byungyoonc/TrueStrike56/hw/pcb/TrueStrike56.kicad_pcb

## KiCad design hw/pcb/TrueStrike56.kicad_pcb (2026-02-21)

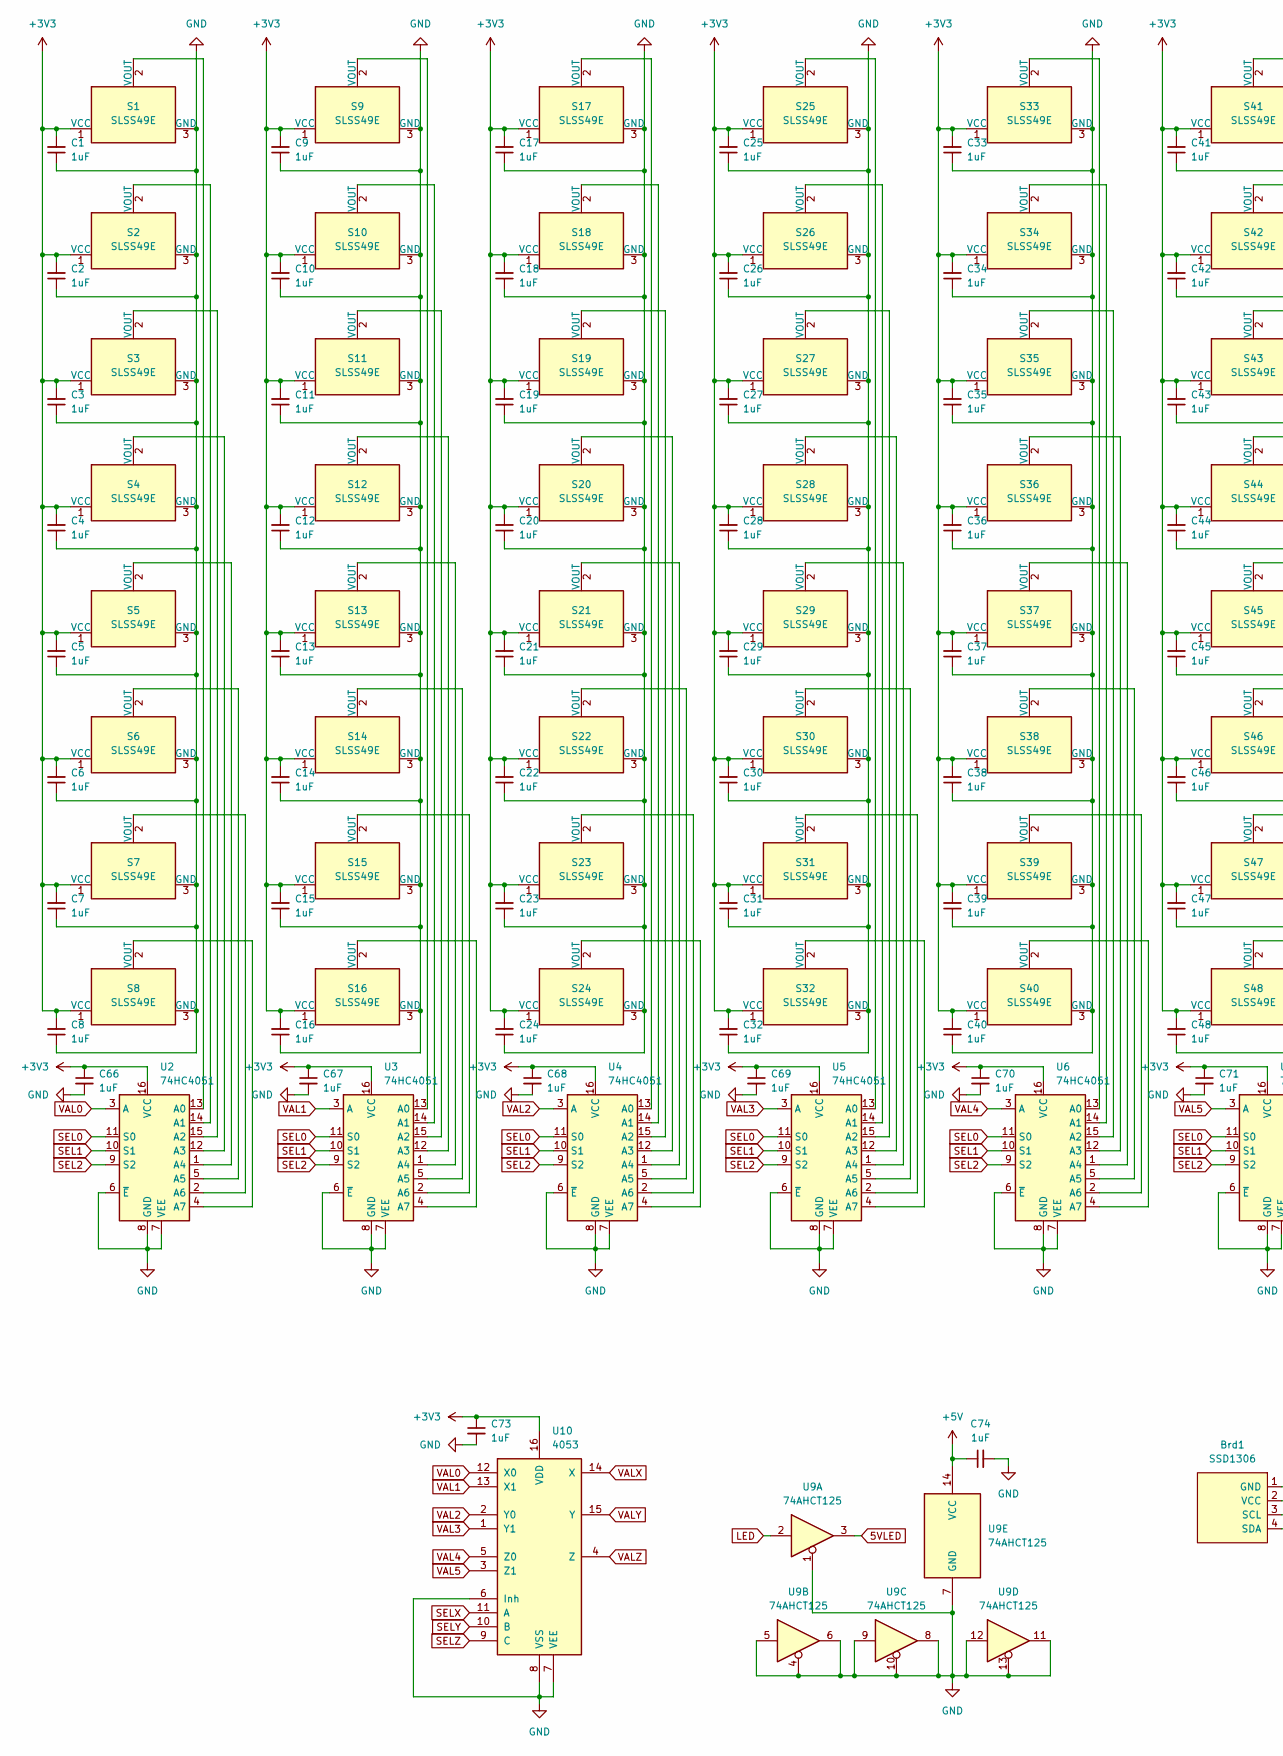
[picture p1: schematic TrueStrike56.kicad_sch, part in row 1, column 1]

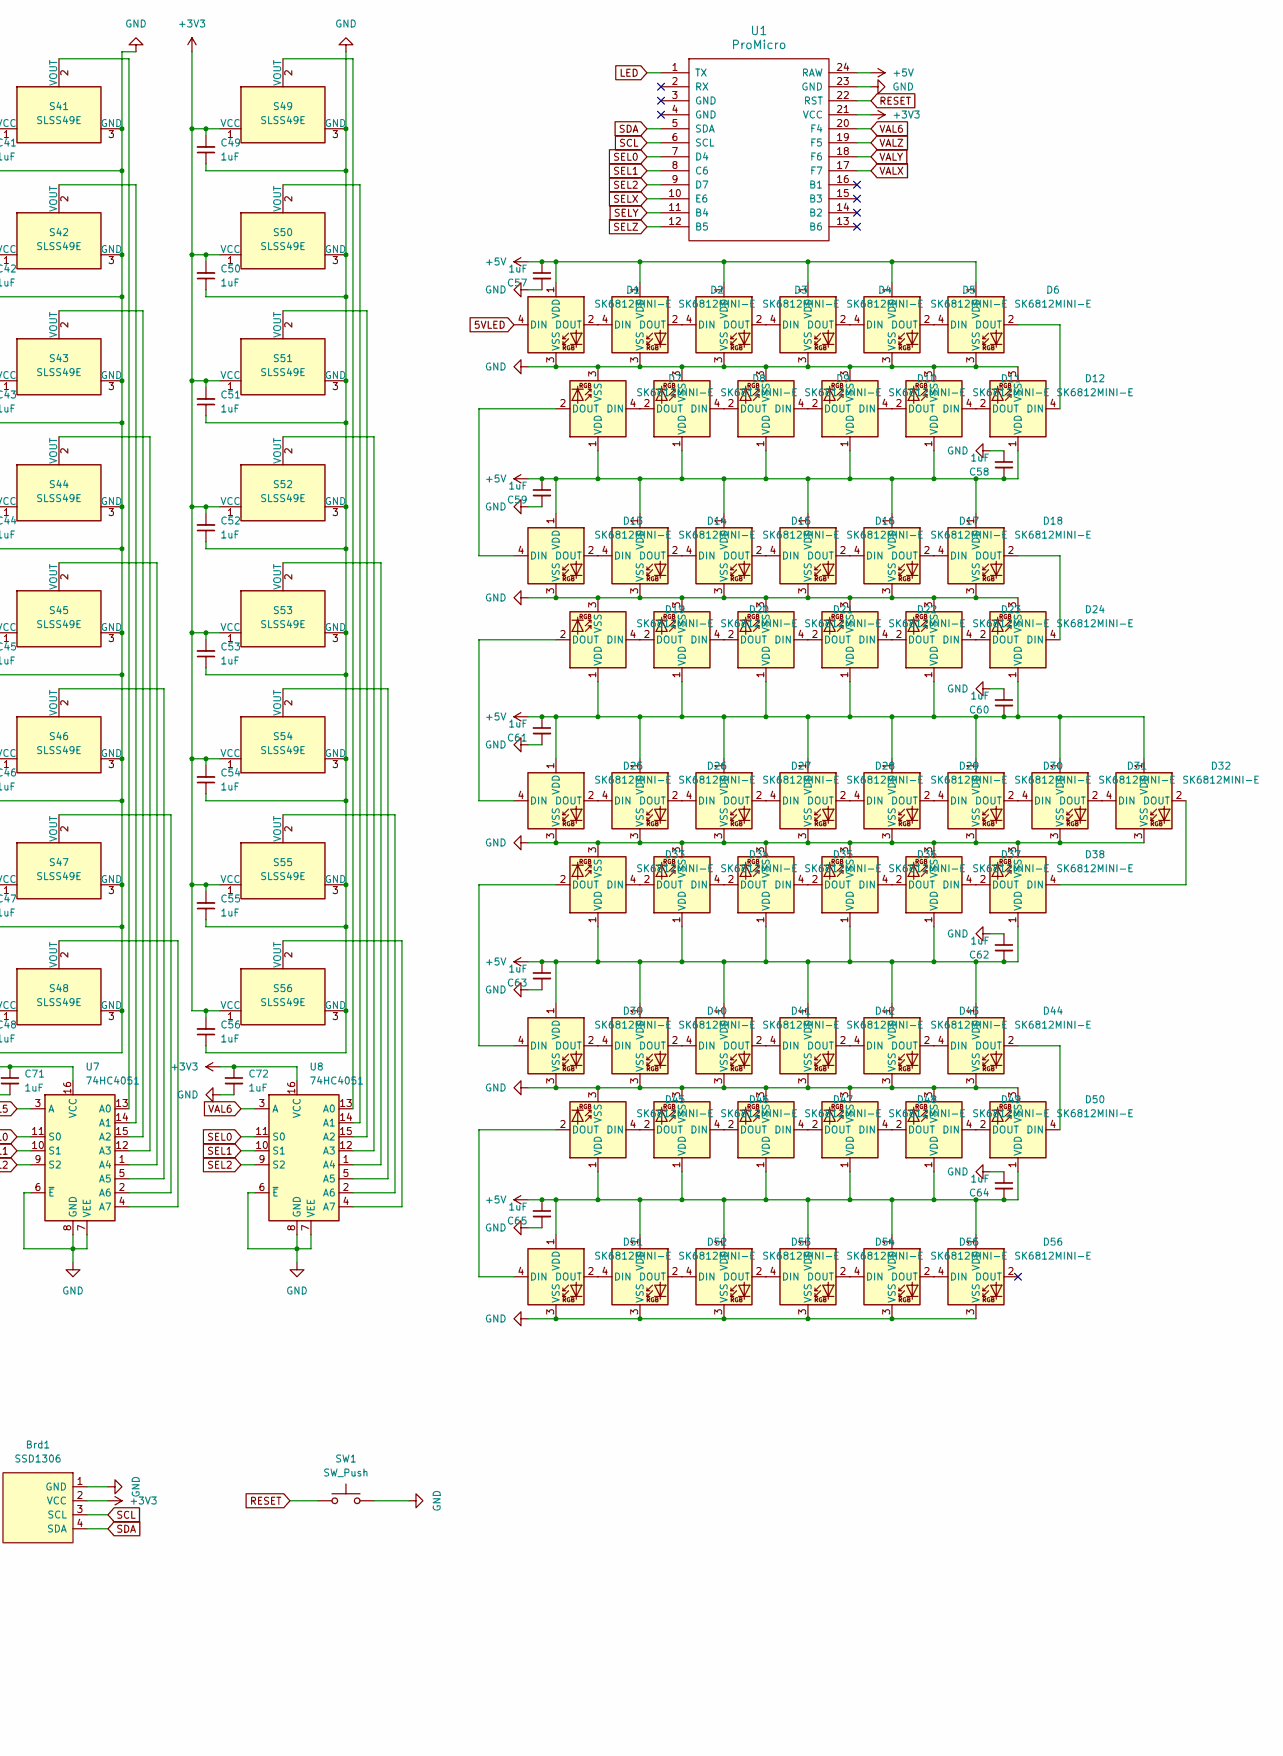
[picture p2: schematic TrueStrike56.kicad_sch, part in row 1, column 2]

Parts:
Brd1: SSD1306; 128x64OLED
C1, C2, C3, C4, C5, C6, C7, C8, C9, C10, C11, C12, C13, C14, C15, C16, C17, C18, C19, C20, C21, C22, C23, C24, C25, C26, C27, C28, C29, C30, C31, C32, C33, C34, C35, C36, C37, C38, C39, C40, C41, C42, C43, C44, C45, C46, C47, C48, C49, C50, C51, C52, C53, C54, C55, C56, C57, C58, C59, C60, C61, C62, C63, C64, C65, C66, C67, C68, C69, C70, C71, C72, C73, C74: 1uF; C_0805_2012Metric_Pad1.18x1.45mm_HandSolder; LCSC Part # C28233
D1, D2, D3, D4, D5, D6, D13, D14, D15, D16, D17, D18, D33, D34, D35, D36, D37, D38, D45, D46, D47, D48, D49, D50: SK6812MINI-E; SK6812MINI-E_nusumi; LCSC Part # C5149201
D7, D8, D9, D10, D11, D12, D19, D20, D21, D22, D23, D24, D25, D26, D27, D28, D29, D30, D31, D32, D39, D40, D41, D42, D43, D44, D51, D52, D53, D54, D55, D56: SK6812MINI-E; SK6812MINI-E_nusumi_Rotated; LCSC Part # C5149201
S1, S2, S3, S4, S5, S6, S7, S8, S9, S10, S11, S12, S13, S14, S15, S16, S17, S18, S19, S20, S21, S22, S23, S24, S25, S26, S27, S28, S29, S30, S31, S32, S33, S34, S35, S36, S37, S38, S39, S40, S41, S42, S43, S44, S45, S46, S47, S48, S49, S50, S51, S54, S55, S56: SLSS49E; HE-Switch-1U; LCSC Part # C126669
S52, S53: SLSS49E; HE-Switch-1.5U; LCSC Part # C126669
SW1: SW_Push; SW_Push_1P1T_XKB_TS-1187A; LCSC Part # C318884
U1: ProMicro
U2, U3, U4, U5, U6, U7, U8: 74HC4051; SOIC-16_3.9x9.9mm_P1.27mm; LCSC Part # C85220
U9: 74AHCT125; SOIC-14_3.9x8.7mm_P1.27mm; LCSC Part # C155176
U10: 4053; SOIC-16_3.9x9.9mm_P1.27mm; LCSC Part # C5647

Connections:
5VLED: D1.4 (DIN), U9.3
+3V3: Brd1.2 (VCC), C1.2, C2.2, C3.2, C4.2, C5.2, C6.2, C7.2, C8.2, C9.2, C10.2, C11.2, C12.2, C13.2, C14.2, C15.2, C16.2, C17.2, C18.2, C19.2, C20.2, C21.2, C22.2, C23.2, C24.2, C25.2, C26.2, C27.2, C28.2, C29.2, C30.2, C31.2, C32.2, C33.2, C34.2, C35.2, C36.2, C37.2, C38.2, C39.2, C40.2, C41.2, C42.2, C43.2, C44.2, C45.2, C46.2, C47.2, C48.2, C49.2, C50.2, C51.2, C52.2, C53.2, C54.2, C55.2, C56.2, C66.1, C67.1, C68.1, C69.1, C70.1, C71.1, C72.1, C73.1, S1.1 (VCC), S2.1 (VCC), S3.1 (VCC), S4.1 (VCC), S5.1 (VCC), S6.1 (VCC), S7.1 (VCC), S8.1 (VCC), S9.1 (VCC), S10.1 (VCC), S11.1 (VCC), S12.1 (VCC), S13.1 (VCC), S14.1 (VCC), S15.1 (VCC), S16.1 (VCC), S17.1 (VCC), S18.1 (VCC), S19.1 (VCC), S20.1 (VCC), S21.1 (VCC), S22.1 (VCC), S23.1 (VCC), S24.1 (VCC), S25.1 (VCC), S26.1 (VCC), S27.1 (VCC), S28.1 (VCC), S29.1 (VCC), S30.1 (VCC), S31.1 (VCC), S32.1 (VCC), S33.1 (VCC), S34.1 (VCC), S35.1 (VCC), S36.1 (VCC), S37.1 (VCC), S38.1 (VCC), S39.1 (VCC), S40.1 (VCC), S41.1 (VCC), S42.1 (VCC), S43.1 (VCC), S44.1 (VCC), S45.1 (VCC), S46.1 (VCC), S47.1 (VCC), S48.1 (VCC), S49.1 (VCC), S50.1 (VCC), S51.1 (VCC), S52.1 (VCC), S53.1 (VCC), S54.1 (VCC), S55.1 (VCC), S56.1 (VCC), U1.21 (VCC), U2.16 (VCC), U3.16 (VCC), U4.16 (VCC), U5.16 (VCC), U6.16 (VCC), U7.16 (VCC), U8.16 (VCC), U10.16 (VDD)
+5V: C57.1, C58.2, C59.1, C60.2, C61.1, C62.2, C63.1, C64.2, C65.1, C74.1, D1.1 (VDD), D2.1 (VDD), D3.1 (VDD), D4.1 (VDD), D5.1 (VDD), D6.1 (VDD), D7.1 (VDD), D8.1 (VDD), D9.1 (VDD), D10.1 (VDD), D11.1 (VDD), D12.1 (VDD), D13.1 (VDD), D14.1 (VDD), D15.1 (VDD), D16.1 (VDD), D17.1 (VDD), D18.1 (VDD), D19.1 (VDD), D20.1 (VDD), D21.1 (VDD), D22.1 (VDD), D23.1 (VDD), D24.1 (VDD), D25.1 (VDD), D26.1 (VDD), D27.1 (VDD), D28.1 (VDD), D29.1 (VDD), D30.1 (VDD), D31.1 (VDD), D32.1 (VDD), D33.1 (VDD), D34.1 (VDD), D35.1 (VDD), D36.1 (VDD), D37.1 (VDD), D38.1 (VDD), D39.1 (VDD), D40.1 (VDD), D41.1 (VDD), D42.1 (VDD), D43.1 (VDD), D44.1 (VDD), D45.1 (VDD), D46.1 (VDD), D47.1 (VDD), D48.1 (VDD), D49.1 (VDD), D50.1 (VDD), D51.1 (VDD), D52.1 (VDD), D53.1 (VDD), D54.1 (VDD), D55.1 (VDD), D56.1 (VDD), U1.24 (RAW), U9.14 (VCC)
GND: Brd1.1 (GND), C1.1, C2.1, C3.1, C4.1, C5.1, C6.1, C7.1, C8.1, C9.1, C10.1, C11.1, C12.1, C13.1, C14.1, C15.1, C16.1, C17.1, C18.1, C19.1, C20.1, C21.1, C22.1, C23.1, C24.1, C25.1, C26.1, C27.1, C28.1, C29.1, C30.1, C31.1, C32.1, C33.1, C34.1, C35.1, C36.1, C37.1, C38.1, C39.1, C40.1, C41.1, C42.1, C43.1, C44.1, C45.1, C46.1, C47.1, C48.1, C49.1, C50.1, C51.1, C52.1, C53.1, C54.1, C55.1, C56.1, C57.2, C58.1, C59.2, C60.1, C61.2, C62.1, C63.2, C64.1, C65.2, C66.2, C67.2, C68.2, C69.2, C70.2, C71.2, C72.2, C73.2, C74.2, D1.3 (VSS), D2.3 (VSS), D3.3 (VSS), D4.3 (VSS), D5.3 (VSS), D6.3 (VSS), D7.3 (VSS), D8.3 (VSS), D9.3 (VSS), D10.3 (VSS), D11.3 (VSS), D12.3 (VSS), D13.3 (VSS), D14.3 (VSS), D15.3 (VSS), D16.3 (VSS), D17.3 (VSS), D18.3 (VSS), D19.3 (VSS), D20.3 (VSS), D21.3 (VSS), D22.3 (VSS), D23.3 (VSS), D24.3 (VSS), D25.3 (VSS), D26.3 (VSS), D27.3 (VSS), D28.3 (VSS), D29.3 (VSS), D30.3 (VSS), D31.3 (VSS), D32.3 (VSS), D33.3 (VSS), D34.3 (VSS), D35.3 (VSS), D36.3 (VSS), D37.3 (VSS), D38.3 (VSS), D39.3 (VSS), D40.3 (VSS), D41.3 (VSS), D42.3 (VSS), D43.3 (VSS), D44.3 (VSS), D45.3 (VSS), D46.3 (VSS), D47.3 (VSS), D48.3 (VSS), D49.3 (VSS), D50.3 (VSS), D51.3 (VSS), D52.3 (VSS), D53.3 (VSS), D54.3 (VSS), D55.3 (VSS), D56.3 (VSS), S1.3 (GND), S2.3 (GND), S3.3 (GND), S4.3 (GND), S5.3 (GND), S6.3 (GND), S7.3 (GND), S8.3 (GND), S9.3 (GND), S10.3 (GND), S11.3 (GND), S12.3 (GND), S13.3 (GND), S14.3 (GND), S15.3 (GND), S16.3 (GND), S17.3 (GND), S18.3 (GND), S19.3 (GND), S20.3 (GND), S21.3 (GND), S22.3 (GND), S23.3 (GND), S24.3 (GND), S25.3 (GND), S26.3 (GND), S27.3 (GND), S28.3 (GND), S29.3 (GND), S30.3 (GND), S31.3 (GND), S32.3 (GND), S33.3 (GND), S34.3 (GND), S35.3 (GND), S36.3 (GND), S37.3 (GND), S38.3 (GND), S39.3 (GND), S40.3 (GND), S41.3 (GND), S42.3 (GND), S43.3 (GND), S44.3 (GND), S45.3 (GND), S46.3 (GND), S47.3 (GND), S48.3 (GND), S49.3 (GND), S50.3 (GND), S51.3 (GND), S52.3 (GND), S53.3 (GND), S54.3 (GND), S55.3 (GND), S56.3 (GND), SW1.2, U1.23 (GND), U2.6 (~E), U2.7 (VEE), U2.8 (GND), U3.6 (~E), U3.7 (VEE), U3.8 (GND), U4.6 (~E), U4.7 (VEE), U4.8 (GND), U5.6 (~E), U5.7 (VEE), U5.8 (GND), U6.6 (~E), U6.7 (VEE), U6.8 (GND), U7.6 (~E), U7.7 (VEE), U7.8 (GND), U8.6 (~E), U8.7 (VEE), U8.8 (GND), U9.1, U9.4, U9.5, U9.6, U9.7 (GND), U9.8, U9.9, U9.10, U9.11, U9.12, U9.13, U10.6 (Inh), U10.7 (VEE), U10.8 (VSS)
LED: U1.1 (TX), U9.2
unnamed: D1.2 (DOUT), D2.4 (DIN)
unnamed: D2.2 (DOUT), D3.4 (DIN)
unnamed: D3.2 (DOUT), D4.4 (DIN)
unnamed: D4.2 (DOUT), D5.4 (DIN)
unnamed: D5.2 (DOUT), D6.4 (DIN)
unnamed: D7.4 (DIN), D8.2 (DOUT)
unnamed: D8.4 (DIN), D9.2 (DOUT)
unnamed: D10.4 (DIN), D11.2 (DOUT)
unnamed: D9.4 (DIN), D10.2 (DOUT)
unnamed: D11.4 (DIN), D12.2 (DOUT)
unnamed: D6.2 (DOUT), D12.4 (DIN)
unnamed: D7.2 (DOUT), D13.4 (DIN)
unnamed: D13.2 (DOUT), D14.4 (DIN)
unnamed: D14.2 (DOUT), D15.4 (DIN)
unnamed: D15.2 (DOUT), D16.4 (DIN)
unnamed: D16.2 (DOUT), D17.4 (DIN)
unnamed: D17.2 (DOUT), D18.4 (DIN)
unnamed: D18.2 (DOUT), D24.4 (DIN)
unnamed: D19.4 (DIN), D20.2 (DOUT)
unnamed: D19.2 (DOUT), D25.4 (DIN)
unnamed: D20.4 (DIN), D21.2 (DOUT)
unnamed: D21.4 (DIN), D22.2 (DOUT)
unnamed: D22.4 (DIN), D23.2 (DOUT)
unnamed: D23.4 (DIN), D24.2 (DOUT)
unnamed: D25.2 (DOUT), D26.4 (DIN)
unnamed: D26.2 (DOUT), D27.4 (DIN)
unnamed: D27.2 (DOUT), D28.4 (DIN)
unnamed: D28.2 (DOUT), D29.4 (DIN)
unnamed: D29.2 (DOUT), D30.4 (DIN)
unnamed: D30.2 (DOUT), D31.4 (DIN)
unnamed: D31.2 (DOUT), D32.4 (DIN)
unnamed: D32.2 (DOUT), D38.4 (DIN)
unnamed: D33.4 (DIN), D34.2 (DOUT)
unnamed: D33.2 (DOUT), D39.4 (DIN)
unnamed: D34.4 (DIN), D35.2 (DOUT)
unnamed: D35.4 (DIN), D36.2 (DOUT)
unnamed: D36.4 (DIN), D37.2 (DOUT)
unnamed: D37.4 (DIN), D38.2 (DOUT)
unnamed: D39.2 (DOUT), D40.4 (DIN)
unnamed: D40.2 (DOUT), D41.4 (DIN)
unnamed: D41.2 (DOUT), D42.4 (DIN)
unnamed: D42.2 (DOUT), D43.4 (DIN)
unnamed: D43.2 (DOUT), D44.4 (DIN)
unnamed: D44.2 (DOUT), D50.4 (DIN)
unnamed: D45.4 (DIN), D46.2 (DOUT)
unnamed: D45.2 (DOUT), D51.4 (DIN)
unnamed: D46.4 (DIN), D47.2 (DOUT)
unnamed: D47.4 (DIN), D48.2 (DOUT)
unnamed: D48.4 (DIN), D49.2 (DOUT)
unnamed: D49.4 (DIN), D50.2 (DOUT)
unnamed: D51.2 (DOUT), D52.4 (DIN)
unnamed: D52.2 (DOUT), D53.4 (DIN)
unnamed: D53.2 (DOUT), D54.4 (DIN)
unnamed: D54.2 (DOUT), D55.4 (DIN)
unnamed: D55.2 (DOUT), D56.4 (DIN)
unnamed: S1.2 (VOUT), U2.13 (A0)
unnamed: S2.2 (VOUT), U2.14 (A1)
unnamed: S3.2 (VOUT), U2.15 (A2)
unnamed: S4.2 (VOUT), U2.12 (A3)
unnamed: S5.2 (VOUT), U2.1 (A4)
unnamed: S6.2 (VOUT), U2.5 (A5)
unnamed: S7.2 (VOUT), U2.2 (A6)
unnamed: S8.2 (VOUT), U2.4 (A7)
unnamed: S9.2 (VOUT), U3.13 (A0)
unnamed: S10.2 (VOUT), U3.14 (A1)
unnamed: S11.2 (VOUT), U3.15 (A2)
unnamed: S12.2 (VOUT), U3.12 (A3)
unnamed: S13.2 (VOUT), U3.1 (A4)
unnamed: S14.2 (VOUT), U3.5 (A5)
unnamed: S15.2 (VOUT), U3.2 (A6)
unnamed: S16.2 (VOUT), U3.4 (A7)
unnamed: S17.2 (VOUT), U4.13 (A0)
unnamed: S18.2 (VOUT), U4.14 (A1)
unnamed: S19.2 (VOUT), U4.15 (A2)
unnamed: S20.2 (VOUT), U4.12 (A3)
unnamed: S21.2 (VOUT), U4.1 (A4)
unnamed: S22.2 (VOUT), U4.5 (A5)
unnamed: S23.2 (VOUT), U4.2 (A6)
unnamed: S24.2 (VOUT), U4.4 (A7)
unnamed: S25.2 (VOUT), U5.13 (A0)
unnamed: S26.2 (VOUT), U5.14 (A1)
unnamed: S27.2 (VOUT), U5.15 (A2)
unnamed: S28.2 (VOUT), U5.12 (A3)
unnamed: S29.2 (VOUT), U5.1 (A4)
unnamed: S30.2 (VOUT), U5.5 (A5)
unnamed: S31.2 (VOUT), U5.2 (A6)
unnamed: S32.2 (VOUT), U5.4 (A7)
unnamed: S33.2 (VOUT), U6.13 (A0)
unnamed: S34.2 (VOUT), U6.14 (A1)
unnamed: S35.2 (VOUT), U6.15 (A2)
unnamed: S36.2 (VOUT), U6.12 (A3)
unnamed: S37.2 (VOUT), U6.1 (A4)
unnamed: S38.2 (VOUT), U6.5 (A5)
unnamed: S39.2 (VOUT), U6.2 (A6)
unnamed: S40.2 (VOUT), U6.4 (A7)
unnamed: S41.2 (VOUT), U7.13 (A0)
unnamed: S42.2 (VOUT), U7.14 (A1)
unnamed: S43.2 (VOUT), U7.15 (A2)
unnamed: S44.2 (VOUT), U7.12 (A3)
unnamed: S45.2 (VOUT), U7.1 (A4)
unnamed: S46.2 (VOUT), U7.5 (A5)
unnamed: S47.2 (VOUT), U7.2 (A6)
unnamed: S48.2 (VOUT), U7.4 (A7)
unnamed: S49.2 (VOUT), U8.13 (A0)
unnamed: S50.2 (VOUT), U8.14 (A1)
unnamed: S51.2 (VOUT), U8.15 (A2)
unnamed: S52.2 (VOUT), U8.12 (A3)
unnamed: S53.2 (VOUT), U8.1 (A4)
unnamed: S54.2 (VOUT), U8.5 (A5)
unnamed: S55.2 (VOUT), U8.2 (A6)
unnamed: S56.2 (VOUT), U8.4 (A7)
RESET: SW1.1, U1.22 (RST)
SCL: Brd1.3 (SCL), U1.6 (SCL)
SDA: Brd1.4 (SDA), U1.5 (SDA)
SEL0: U1.7 (D4), U2.11 (S0), U3.11 (S0), U4.11 (S0), U5.11 (S0), U6.11 (S0), U7.11 (S0), U8.11 (S0)
SEL1: U1.8 (C6), U2.10 (S1), U3.10 (S1), U4.10 (S1), U5.10 (S1), U6.10 (S1), U7.10 (S1), U8.10 (S1)
SEL2: U1.9 (D7), U2.9 (S2), U3.9 (S2), U4.9 (S2), U5.9 (S2), U6.9 (S2), U7.9 (S2), U8.9 (S2)
SELX: U1.10 (E6), U10.11 (A)
SELY: U1.11 (B4), U10.10 (B)
SELZ: U1.12 (B5), U10.9 (C)
VAL0: U2.3 (A), U10.12 (X0)
VAL1: U3.3 (A), U10.13 (X1)
VAL2: U4.3 (A), U10.2 (Y0)
VAL3: U5.3 (A), U10.1 (Y1)
VAL4: U6.3 (A), U10.5 (Z0)
VAL5: U7.3 (A), U10.3 (Z1)
VAL6: U1.20 (F4), U8.3 (A)
VALX: U1.17 (F7), U10.14 (X)
VALY: U1.18 (F6), U10.15 (Y)
VALZ: U1.19 (F5), U10.4 (Z)

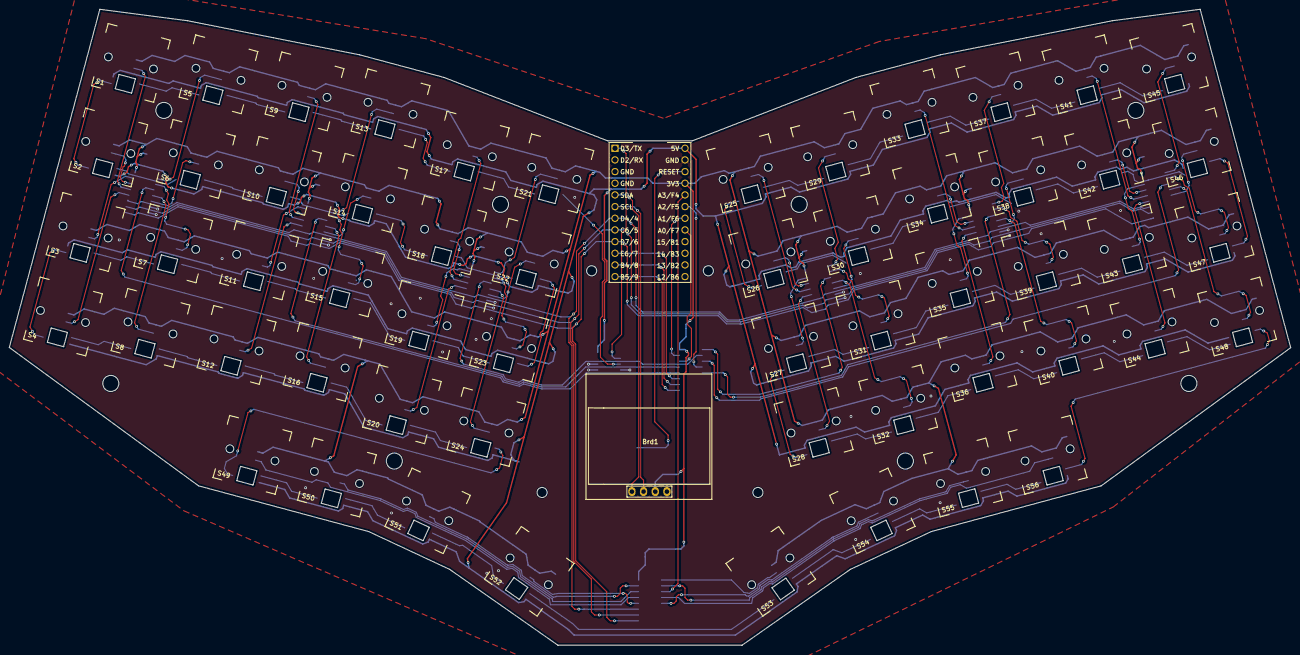
[picture p3: board TrueStrike56.kicad_pcb from above]

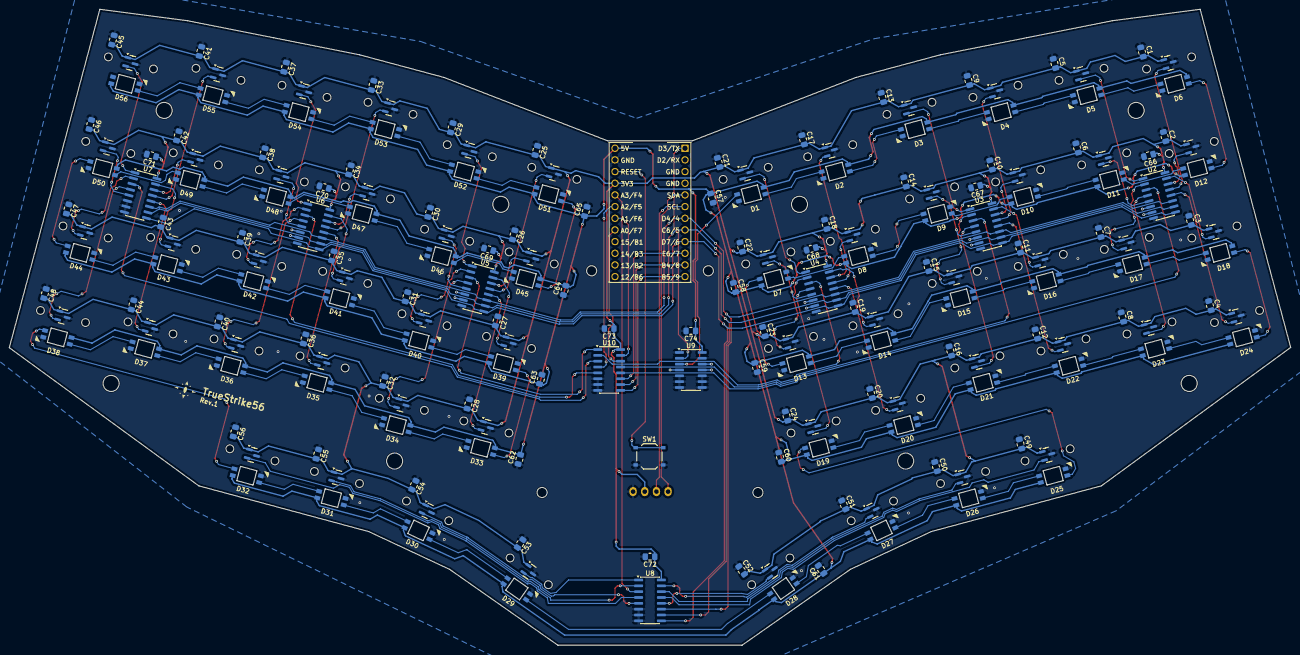
[picture p4: board TrueStrike56.kicad_pcb from below]

Board: 2 copper layers, 278.9 x 138.4 mm, 198 parts (196 on the bottom side), 135 nets.
