byungyoonc/TrueStrike56/fw/rev2/truestrike56/keymaps/via/keymap.c

// Copyright 2025 byungyoonc
// SPDX-License-Identifier: GPL-2.0-or-later

#include QMK_KEYBOARD_H

const uint16_t PROGMEM keymaps[][MATRIX_ROWS][MATRIX_COLS] = {
    [0] = LAYOUT_split_4x6_4(
        KC_ESC,  KC_1,    KC_2,    KC_3,    KC_4,    KC_5,                               KC_6,    KC_7,    KC_8,    KC_9,    KC_0,    KC_DEL,
        KC_TAB,  KC_Q,    KC_W,    KC_E,    KC_R,    KC_T,                               KC_Y,    KC_U,    KC_I,    KC_O,    KC_P,    KC_BSPC,
        KC_LCTL, KC_A,    KC_S,    KC_D,    KC_F,    KC_G,                               KC_H,    KC_J,    KC_K,    KC_L,    KC_SCLN, KC_ENT,
        KC_LSFT, KC_Z,    KC_X,    KC_C,    KC_V,    KC_B,                               KC_N,    KC_M,    KC_COMM, KC_DOT,  KC_SLSH, KC_RSFT,
                                   KC_LGUI, KC_LALT, TL_LOWR, KC_LSFT,          KC_SPC,  TL_UPPR, KC_RALT, KC_RGUI, KC_MUTE
    ),
    [1] = LAYOUT_split_4x6_4(
        _______, _______, _______, _______, _______, _______,                            _______, _______, _______, _______, _______, _______,
        _______, KC_HOME, KC_UP,   KC_END,  KC_PGUP, KC_CAPS,                            KC_NUM,  KC_P7,   KC_P8,   KC_P9,   KC_PMNS, _______,
        _______, KC_LEFT, KC_DOWN, KC_RGHT, KC_PGDN, _______,                            _______, KC_P4,   KC_P5,   KC_P6,   KC_PPLS, _______,
        _______, _______, _______, _______, _______, _______,                            _______, KC_P1,   KC_P2,   KC_P3,   KC_PDOT, _______,
                                   _______, _______, _______, _______,          KC_P0,   _______, _______, _______, _______
    ),
    [2] = LAYOUT_split_4x6_4(
        KC_GRV,  _______, _______, _______, _______, _______,                            _______, _______, _______, _______, _______, _______,
        _______, _______, _______, _______, _______, _______,                            _______, KC_LPRN, KC_RPRN, KC_MINS, KC_EQL,  _______,
        _______, _______, _______, _______, _______, _______,                            _______, KC_LBRC, KC_RBRC, KC_BSLS, KC_QUOT, _______,
        _______, _______, _______, _______, _______, _______,                            _______, _______, _______, _______, _______, _______,
                                   _______, _______, _______, _______,          _______, _______, _______, _______, _______
    ),
    [3] = LAYOUT_split_4x6_4(
        _______, _______, _______, _______, _______, _______,                            _______, _______, _______, _______, _______, _______,
        QK_BOOT, _______, _______, _______, _______, _______,                            _______, KC_F7,   KC_F8,   KC_F9,   KC_F10,  KC_PSCR,
        EE_CLR,  _______, _______, _______, _______, _______,                            _______, KC_F4,   KC_F5,   KC_F6,   KC_F11,  _______,
        _______, NK_TOGG, _______, _______, _______, _______,                            _______, KC_F1,   KC_F2,   KC_F3,   KC_F12,  _______,
                                   _______, _______, _______, _______,          _______, _______, _______, _______, _______
    )
};

const uint16_t PROGMEM encoder_map[][NUM_ENCODERS][NUM_DIRECTIONS] = {
    [0] = { ENCODER_CCW_CW(KC_VOLD, KC_VOLU) },
    [1] = { ENCODER_CCW_CW(KC_VOLD, KC_VOLU) },
    [2] = { ENCODER_CCW_CW(KC_VOLD, KC_VOLU) },
    [3] = { ENCODER_CCW_CW(KC_VOLD, KC_VOLU) }
};
