byungyoonc/TrueStrike56/(commit log)

2026-02-09 Upload PCB design files + submodules
    [TrueStrike56.kicad_pcb, TrueStrike56.kicad_sch]
2026-02-11 Add mounting holes and plates, MCU cover
    [TrueStrike56.kicad_pcb, bottom-plate.kicad_pcb, bottom-plate.kicad_sch, mcu-cover.kicad_pcb, mcu-cover.kicad_sch, top-plate.kicad_pcb, top-plate.kicad_sch]
2026-02-21 Add logo+model name+rev #, set LCSC Part # for PCBA order
    [TrueStrike56.kicad_pcb, TrueStrike56.kicad_sch]
2026-02-21 Add Gerber, production files
    [TrueStrike56-B_Cu.gbl, TrueStrike56-B_Mask.gbs, TrueStrike56-B_Paste.gbp, TrueStrike56-B_Silkscreen.gbo, TrueStrike56-Edge_Cuts.gm1, TrueStrike56-F_Cu.gtl, TrueStrike56-F_Mask.gts, TrueStrike56-F_Paste.gtp]
2026-02-21 Update PCB and production files for PCBA
    Changed RESET tactile switch to JLCPCB PCBA compatible part
    [TrueStrike56-B_Cu.gbl, TrueStrike56-B_Mask.gbs, TrueStrike56-B_Paste.gbp, TrueStrike56-B_Silkscreen.gbo, TrueStrike56-Edge_Cuts.gm1, TrueStrike56-F_Cu.gtl, TrueStrike56-F_Mask.gts, TrueStrike56-F_Paste.gtp]
2026-02-21 Add production files for the rest
    [bottom-plate-B_Cu.gbl, bottom-plate-B_Mask.gbs, bottom-plate-B_Paste.gbp, bottom-plate-B_Silkscreen.gbo, bottom-plate-Edge_Cuts.gm1, bottom-plate-F_Cu.gtl, bottom-plate-F_Mask.gts, bottom-plate-F_Paste.gtp]
2026-02-21 Update HE switch footprint to have the correct side
    [TrueStrike56-B_Cu.gbl, TrueStrike56-B_Mask.gbs, TrueStrike56-B_Paste.gbp, TrueStrike56-B_Silkscreen.gbo, TrueStrike56-Edge_Cuts.gm1, TrueStrike56-F_Cu.gtl, TrueStrike56-F_Mask.gts, TrueStrike56-F_Paste.gtp]
2026-06-20 Add bottom and top plates for rev2 HW
    [bottom-plate.kicad_pcb, bottom-plate.kicad_sch, top-plate.kicad_pcb, top-plate.kicad_sch]
2026-06-20 Update existing kicad project version
2026-06-20 Add gerber output files for rev2 HW
    [TrueStrike56-B_Cu.gbl, TrueStrike56-B_Mask.gbs, TrueStrike56-B_Paste.gbp, TrueStrike56-B_Silkscreen.gbo, TrueStrike56-Edge_Cuts.gm1, TrueStrike56-F_Cu.gtl, TrueStrike56-F_Mask.gts, TrueStrike56-F_Paste.gtp]
2026-06-20 Add PCBA output files for rev2 PCB
    [bom.csv, designators.csv, positions.csv]
2026-06-20 Update BOM's LCSC # based on JLCPCB inventory
    [bom.csv]
2026-07-08 Fix updated calculation for dip switch
    [dip_switch_matrix.c]
